yoobzz/scroll-guard/(commit log)

2026-10-29 feat: scroll guard — camera detects phone scrolling, ESP32 relay cuts the router
    - YOLO26 detection: people + keypoints on the full frame, phone search in
    each person's upscaled crop; a phone counts only near its owner's visible face
    - per-person tracking and timers (10 s window, break resets the streak)
    - ESP32 / ESP32-C3 firmware: relay on the router's DC line through NC,
    the board keeps the ban timer itself, optional key, BOOT = unban
    - local web page with live preview and settings
    - Home Assistant add-on (ingress, options, entities, scroll_guard_ban event)
    - English docs: README, hardware (parts list, wiring), API; wiring diagram
    [config.example.h]
2026-10-29 ci: unit tests and firmware build for ESP32 / ESP32-C3
2026-10-29 fix: count a phone in hand when the head is cut off by the frame
    The face rule ruled out anyone whose face was not visible, including a
    person standing close to the camera with their head above the top edge
    (the fourth person in the demo photo). Now, when the shoulders sit within
    0.6 shoulder widths of the top edge, the person faces the camera (left
    shoulder/hip on the right of the image) and holds the phone above the
    hips, the phone counts. Back to the camera still does not count.
    A smaller phone box lying mostly inside a bigger one is now the same
    phone, so no stray grey "phone nearby" box. Reasons shown on the page
    are in English.
2026-10-29 feat: English UI, laptop and ESP32 camera sources, camera guide
    - Page, preview overlay and messages in English: "You're doom
    scrolling", DOOM SCROLLING / NOT SCROLLING per person with their timer
    as a second tag, labels shrink to fit the person's box.
    - More -> Camera: IP camera, ESP32 camera and Laptop camera buttons.
    The first two fill in an address template with the part to change
    selected; the laptop button saves at once (hidden in the add-on).
    - "laptop" source: on a Mac picks the built-in camera by name through
    ffmpeg (skips OBS, iPhone Continuity Camera, Desk View), on Linux
    /dev/video0. "mac" still works. Source parsing lives in zrodla.py so
    CI can test it without Open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
